jbrathwa/SignAlly/3D file/signally-cad-document.step

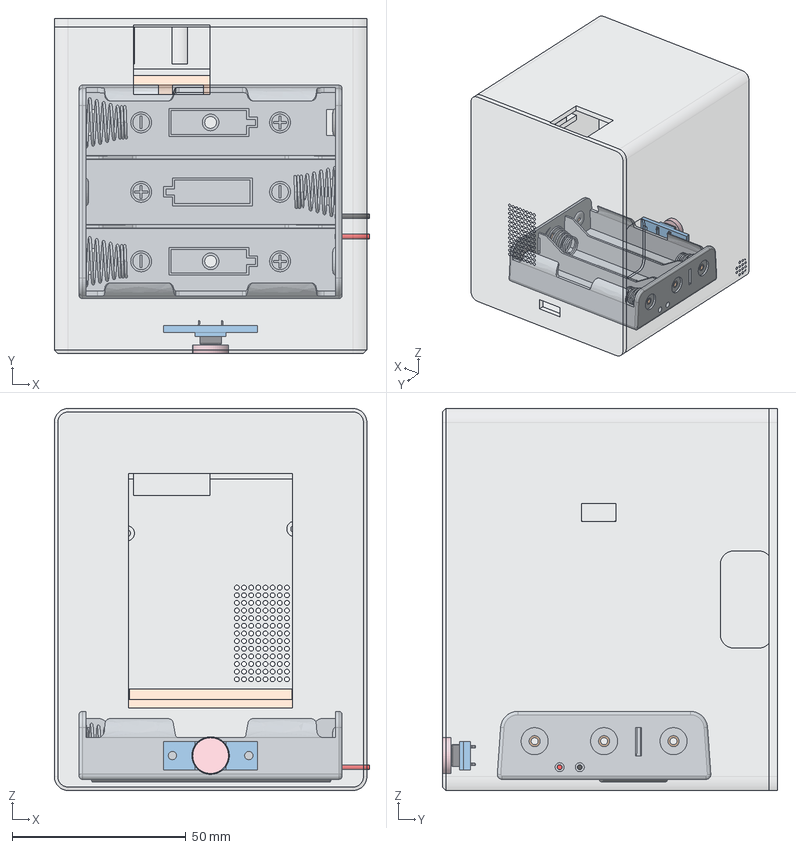
[picture p4: CAD file, 2026-09-13]
3D file/signally-cad-document.step
90.8 x 96.5 x 110.0 mm
FrontShell
Corps
FilNoirUnder001
Positif1
Spring1
Spring3
rivet
rivet001
rivet002
rivet003
rivet004
rivet005
Positif2
Positif3
FilRouge
FilNoir
FilNoirUnder
PWR_Lid
RearLid
Btn2_Cap
Btn2_Base
buttonRot
