jbrathwa/SignAlly/panel/src/ui_icons.c

/**
 * @file ui_icons.c
 * Status-bar icon image assets for the CrowPanel 2.8" HMI.
 *
 * GENERATED FILE - do not hand-edit.
 * Source artwork: assets/icons/ (regenerate with tools/gen_icons.py)
 *
 * Format: LV_IMG_CF_ALPHA_8BIT, 20x20, 400 bytes each.
 * Alpha-only images are blended using the object's `img_recolor` style as a
 * solid colour, with these bytes acting as an antialiased coverage mask, so a
 * single asset serves both the idle and active tint. Callers MUST also set
 * `img_recolor_opa` to LV_OPA_COVER -- LVGL ignores `img_recolor` when the
 * recolor opacity is zero and the icon would silently render black.
 */

#include "ui_icons.h"

#ifndef LV_ATTRIBUTE_MEM_ALIGN
#define LV_ATTRIBUTE_MEM_ALIGN
#endif

static const LV_ATTRIBUTE_MEM_ALIGN uint8_t ui_img_camera_map[] = {
    0x00, 0x00, 0x00, 0x00, 0x00, 0x00, 0x00, 0x00, 0x00, 0x00, 0x00, 0x00, 0x00, 0x00, 0x00, 0x00,
    0x00, 0x00, 0x00, 0x00, 0x00, 0x00, 0x00, 0x00, 0x00, 0x00, 0x00, 0x00, 0x00, 0x00, 0x00, 0x00,
    0x00, 0x00, 0x00, 0x00, 0x00, 0x00, 0x00, 0x00, 0x00, 0x00, 0x00, 0x00, 0x00, 0x00, 0x00, 0x00,
    0x00, 0x00, 0x00, 0x00, 0x00, 0x00, 0x00, 0x00, 0x00, 0x00, 0x00, 0x00, 0x00, 0x00, 0x00, 0x00,
    0x41, 0x9e, 0x9f, 0x9f, 0x4a, 0x00, 0x00, 0x00, 0x00, 0x00, 0x00, 0x00, 0x00, 0x00, 0x00, 0x00,
    0x00, 0x00, 0x00, 0x00, 0xca, 0xfd, 0xdf, 0xfb, 0xda, 0x00, 0x00, 0x00, 0x00, 0x00, 0x00, 0x00,
    0x00, 0x00, 0x00, 0x00, 0x00, 0x00, 0x00, 0x00, 0xcf, 0xa6, 0x00, 0x96, 0xdf, 0x00, 0x00, 0x00,
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
    0x00, 0x00, 0x00, 0x00, 0x00, 0x00, 0x00, 0x00, 0x00, 0x00, 0x00, 0x00, 0x00, 0x00, 0x00, 0x00,
    0x00, 0x00, 0x00, 0x00, 0x00, 0x00, 0x00, 0x00, 0x00, 0x00, 0x00, 0x00, 0x00, 0x00, 0x00, 0x00,
};

const lv_img_dsc_t ui_img_speaker_muted = {
    .header.cf = LV_IMG_CF_ALPHA_8BIT,
    .header.always_zero = 0,
    .header.reserved = 0,
    .header.w = 20,
    .header.h = 20,
    .data_size = 400,
    .data = ui_img_speaker_muted_map,
};
