jbrathwa/SignAlly/(commit log)

2026-09-05 feat(protocol): v1 line encoding with the 256-byte frame guard
2026-09-05 feat(core): device state and the gesture lifecycle, deduped
2026-09-05 feat(hub): seq stamping, fan-out, and replay on connect
2026-09-05 feat(audio): threaded player, mute gate, tolerant of every failure
2026-09-05 feat(upstream): SSE client with comment-tolerant liveness and reconnect
    Read loop uses a bounded per-line timeout (not None) so stop() can't
    leave the reader thread blocked past its join; also closes leaked
    HTTPError bodies on non-2xx reconnect attempts.
2026-09-05 feat(cli): wire the service together, end-to-end tests, README
2026-09-05 fix(upstream): select-guarded reads, not a socket timeout
    A 0.5 s read timeout latches SocketIO._timeout_occurred on its first tick,
    so every later read raised OSError and the stream reconnected ~40x/minute,
    losing events and defeating the offline watchdog.
2026-09-05 fix(main): shut the accept loop down before closing the server socket
2026-09-05 fix(upstream): interrupt the socket on stop instead of gating reads on select
    select() cannot see body bytes the header read already pulled into the
    response's buffer, so an event arriving with the headers was stranded. Reads
    are now plain and untimed; stop() shuts the socket down under them.
2026-09-06 fix(script): probe for the camera, the index is not stable
2026-09-06 feat(health): report the islkit version and encoder fingerprint
2026-09-06 docs(readme): document the whole device stack, not just the orchestrator
2026-09-06 feat(panel): bring the panel firmware in and drive it over a Bridge relay
2026-09-07 feat(applab): flash the panel relay from the console app
    App Lab discovers a sketch only at <app>/sketch/sketch.ino, so a relay kept
    under mcu/ was never flashed and the failure was silent: panel_hello timed out
    and the console fell back to standing in. Verified end to end on white-witch.
    [config.h, sketch.ino, uno_q_mcu_uart_test.ino]
2026-09-07 feat(recognition): thread MediaPipe and report the count in /health
2026-09-07 fix(recognition): size take timing against the rate actually observed
    rest_to_close scaled down to 2 frames at the board's 3 fps, and dropout runs
    there are 1-5 — so 85.7% of dropouts closed a take mid-sign and 32% came back
    too_short. Dropout length does not shrink with the frame rate; the floor does
    not either.
2026-09-07 feat(scripts): start with three xnnpack threads and the 17-class head
2026-09-07 fix(panel): replace a raw NUL byte with the \0 escape
    The file read as binary, so grep skipped it and git showed no diffs.
    [ui_center.c]
2026-09-13 fix(panel): Start/Stop toggles capture from any screen; docs: 6-sign head, screen flows
    [buttons.c, buttons.h, uart_link.cpp, ui_center.c]
2026-09-13 add: 3D design step file
    [signally-cad-document.step]
2026-09-13 docs(schematics): add power, display and button/audio sheets
2026-09-13 docs(hardware): add hardware guide with net list, BOM and build status
